1cfer/GloboRadiante/docs/prototipo-2.jpg

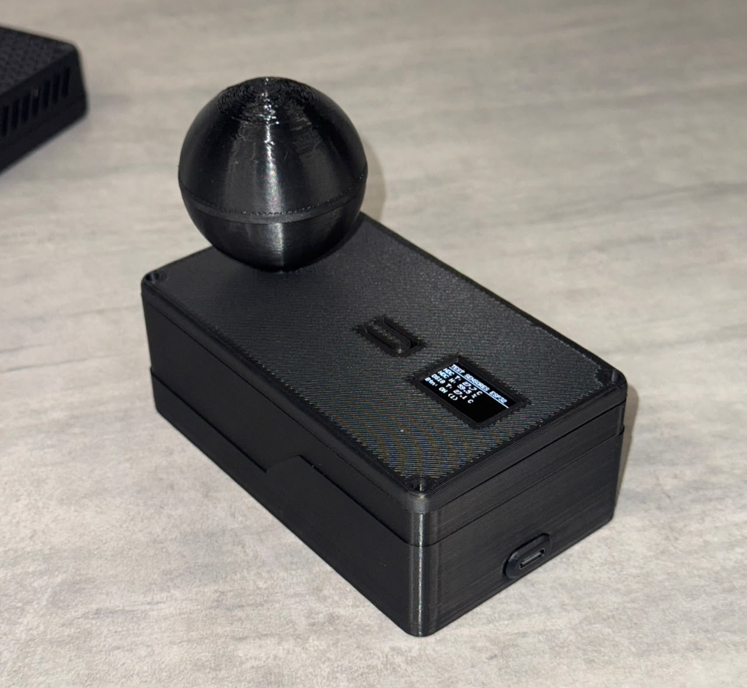
docs/prototipo-2.jpg
