1cfer/GloboRadiante/(commit log)

2026-09-22 Publicar firmware y documentación de Globo Radiante
2026-09-22 Diagrama de conexiones
2026-09-22 Revise button GPIO pin and enhance README content
    Updated GPIO pin assignment for the button and added images for better documentation.
2026-09-22 Revise button GPIO pin and enhance README content
    Updated GPIO pin for button connection and added images.
2026-09-22 Change BUTTON_PIN from 0 to 32
